sensics/IR_LED_DRV/Schematics/IR_EVB_REV1.xls

Positional tracker Part II Revised: Sunday, March 15, 2015
Rigid_PCBwLEDS.dsn Revision: 2.0
Copyright © 2015 Sensics, Inc.
Bill Of Materials March 15,2015 6:45:58 | Page1
Item | Quantity | Reference | Part | MNF_PN
______________________________________________
1 | 4 | C1,C2,C5,C6 | 22uF | LMK212BJ226MG-T
2 | 9 | C3,C9,C13,C14,C15,C16,C17,C18,C19 | 0.1uF | C0603C105K3PAC
3 | 1 | C4 | NP | C0603C105K3PAC
4 | 1 | C7 | 100uF | C1210C107M9PACTU
5 | 1 | C8 | 10uF | GRM188R60J106ME47D
6 | 2 | C10,C20 | 4.7uF | C0603C475K8PACTU
7 | 2 | C11,C12 | 33pF | ECJ-0EC1H330J
8 | 1 | D1 | BPW 34 S-Z | 720-BPW34S-Z
9 | 1 | D2 | CDBQR0230L | CDBQR0230L
10 | 1 | IR1 | SFH4710 | 720-SFH4710
11 | 1 | JP1 | Jump | RC0402FR-0715KL
12 | 3 | J1,J2,J3 | STX-3120-3B |  | 3 pin 100 mil connector
13 | 40 | LED1,LED2,LED3,LED4,LED5,LED6,LED7,LED8,LED9,LED10,LED11,LED12,LED13,LED14,LED15,LED16,LED17,LED18,LED19,LED20,LED21,LED22,LED23,LED24,LED25,LED26,LED27,LED28,LED29,LED30,LED31,LED32,LED33,LED34,LED35,LED36,LED37,LED38,LED39,LED40 | SFH4253_1 | SFH 4253-Z
14 | 1 | L1 | 2.2 uH | IHLP2525CZER2R2M01
15 | 1 | P1 | 22272041 | 22272041
16 | 1 | P2 | 55460-0472 | 55460-0472
17 | 1 | R1 | 52.3K | ERJ-2RKF5232X
18 | 2 | R2,R3 | 30.1K | ERJ-2RKF3012X
19 | 1 | R4 | 12.1K | RC0402FR-0712KL
20 | 2 | R5,R13 | 10.0K | RC0402FR-0710KL
21 | 6 | R6,R7,R8,R9,R10,R12 | 330 | MCR01MRTF3300
22 | 1 | R11 | 4.99K | RC0603FR-074K99L
23 | 1 | R14 | 75
24 | 1 | R15 | 120 | RC0402FR-07120RL
25 | 1 | SEN1 | WSLP39211L000FEB | WSLP39211L000FEB
26 | 24 | T1,T2,T3,T4,T5,T6,T7,T8,T9,T10,T11,T12,T13,T14,T15,T16,T17,T18,T19,T20,T21,T22,T23,T24 | TP0_8MM |  | NP
27 | 1 | U1 | ST1S31 | ST1S31PUR
28 | 1 | U2 | TPS7A3701DRVT | TPS7A3701DRVT
29 | 6 | U3,U4,U5,U6,U7,U9 | STP16CPC26XTR | STP16CPC26XTR
30 | 1 | U8 | STM8S003K3T6CTR | STM8S003K3T6CTR
31 | 1 | U11 | VSOP5843 | VSOP58438
32 | 1 | WLD1 | LTW-E670DS | LTW-E670DS
33 | 1 | Y1 | 16MHz | ABLS-24.000MHZ-B4-T |  | NOT for assembling
