sensics/IR_LED_DRV/(list of files, cad)

Other CAD files:
stvd_ir_led_drv_project.stp
