sensics/IR_LED_DRV/(threads)

Thread 2 (2016-11-13):

Program-LedHex.ps1 from the repository doesn't match release zip

ChristophHaag, 2016-11-13:
https://github.com/sensics/IR_LED_DRV/blob/master/Program-LedHex.ps1

rpavlik, 2016-12-09:
Oops - that probably shouldn't even be in this repo. Its home is here: https://github.com/sensics/IR-Board-Programmer
