sensics/IR_LED_DRV/Schematics/evk_pcbwleds_u.pdf

1

2

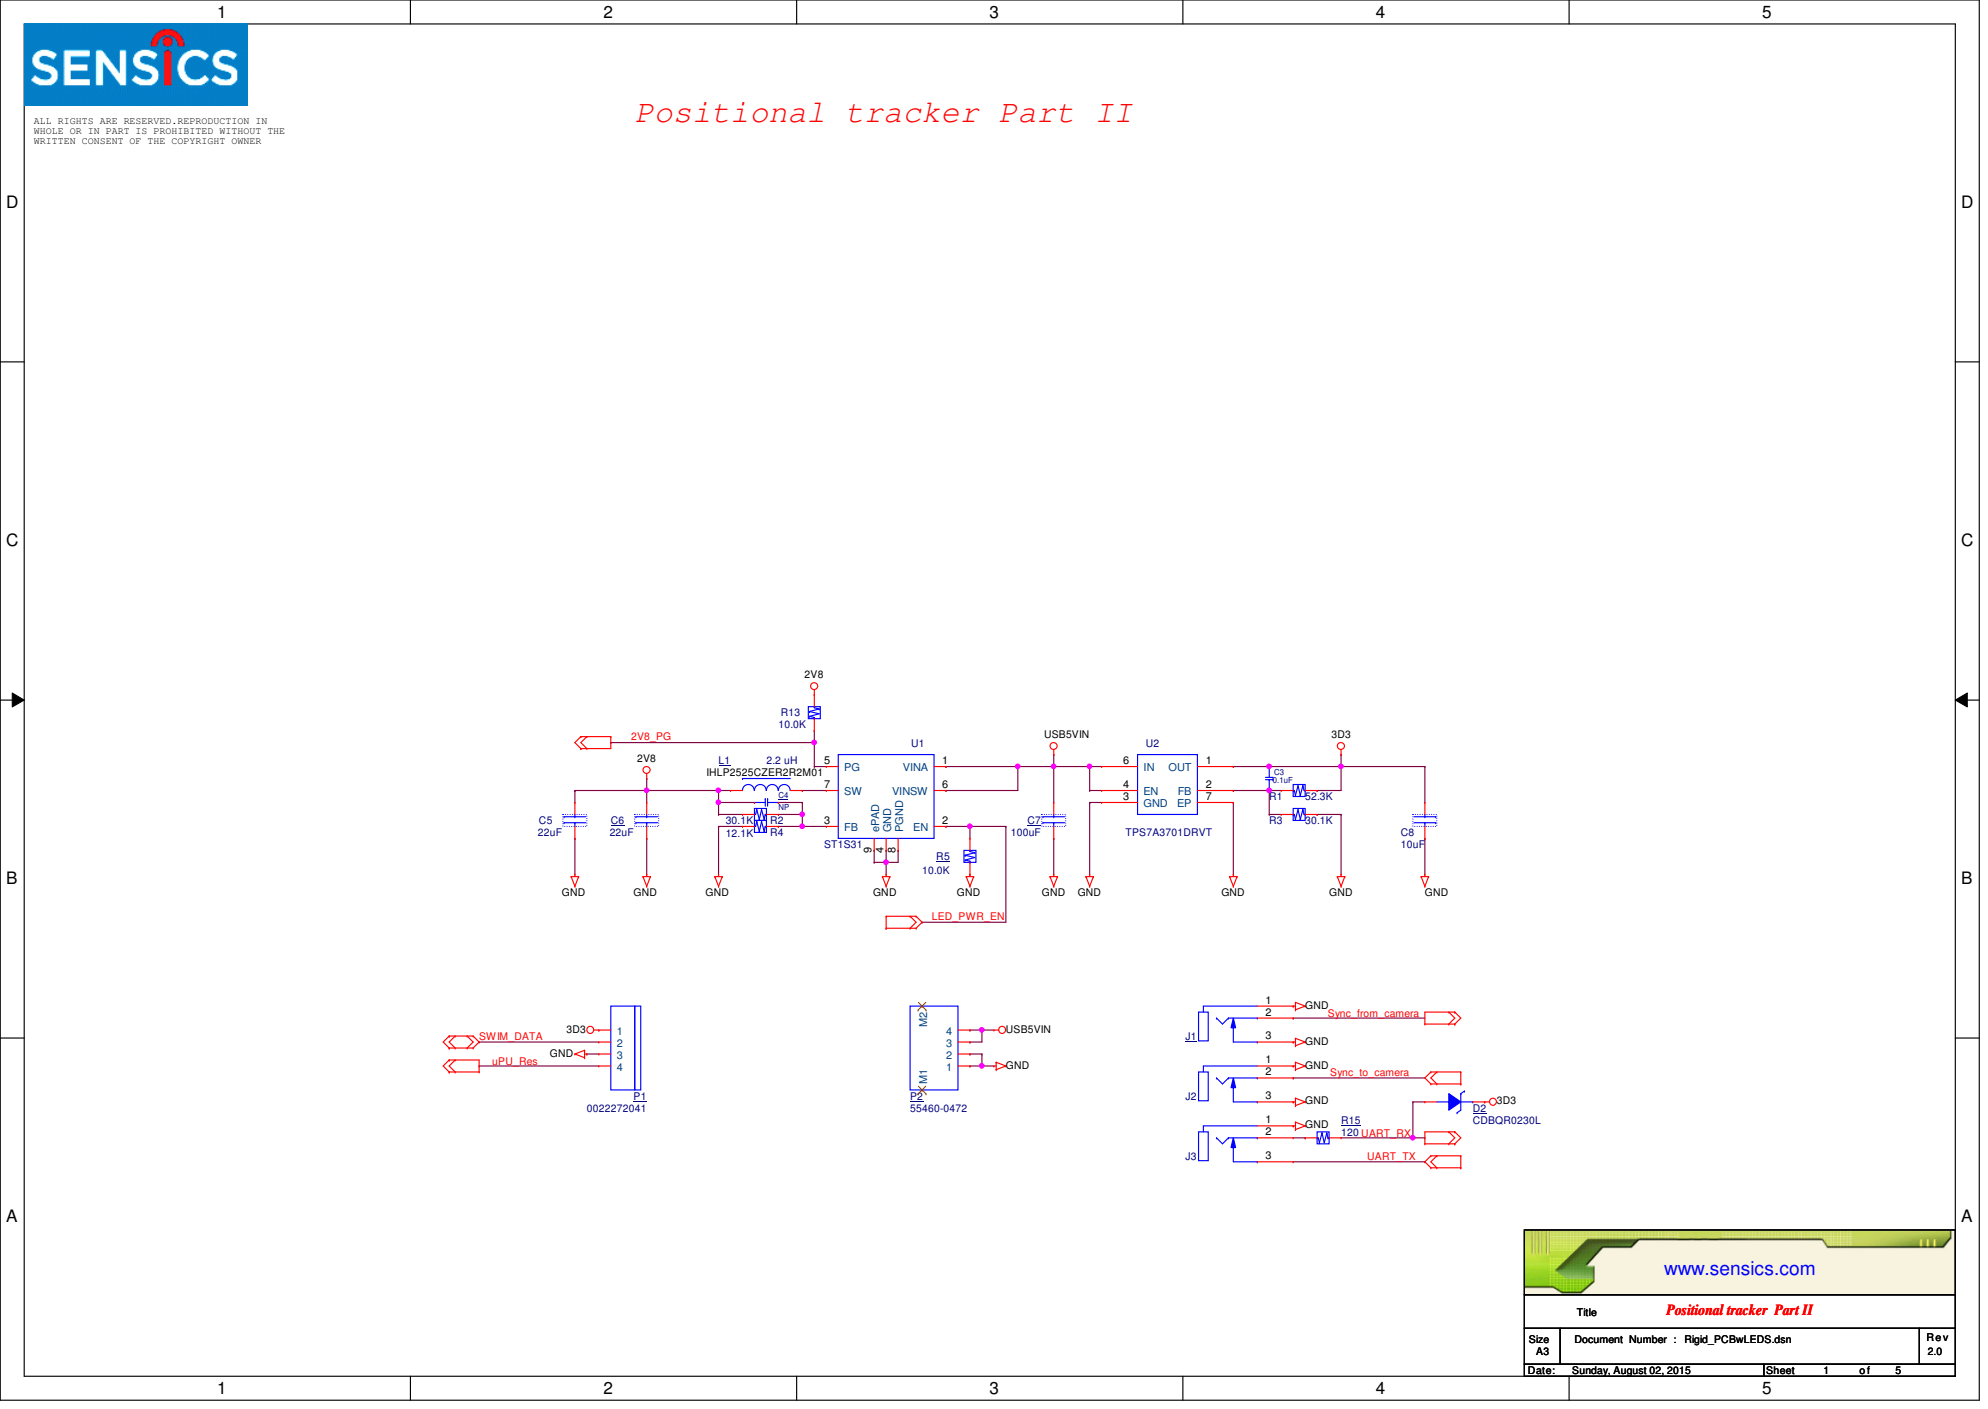
[picture p2: page 1]

Positional tracker Part II

ALL RIGHTS ARE RESERVED.REPRODUCTION IN
WHOLE OR IN PART IS PROHIBITED WITHOUT THE
WRITTEN CONSENT OF THE COPYRIGHT OWNER

D D

# Positional tracker Part II

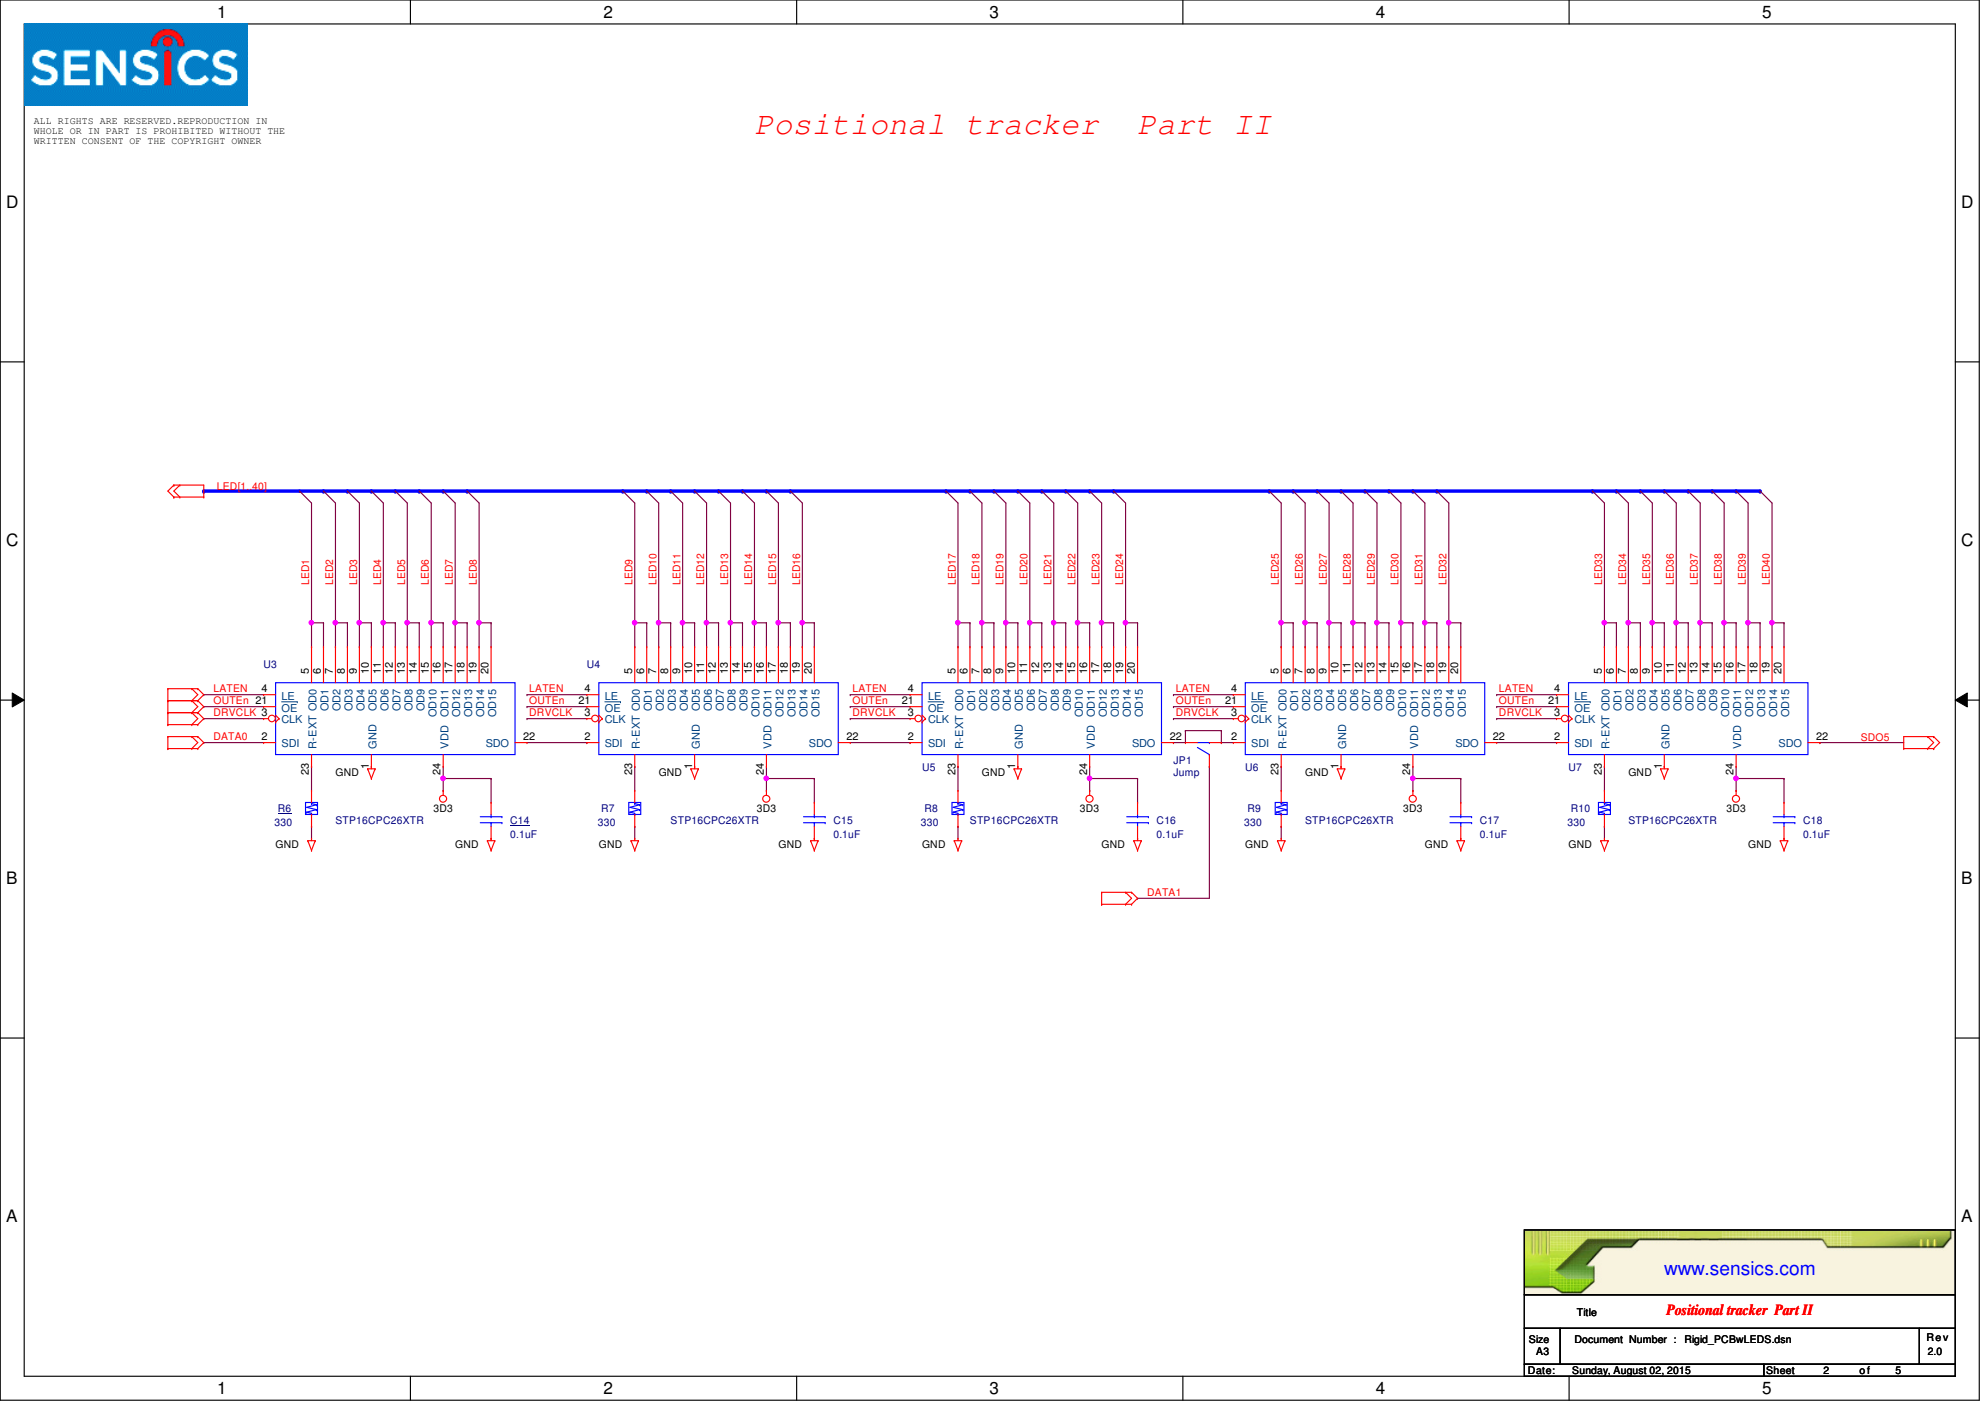
[picture p3: page 2]

WHOLE OR IN PART IS PROHIBITED WITHOUT THE
WRITTEN CONSENT OF THE COPYRIGHT OWNER

D D

# Positional tracker Part II

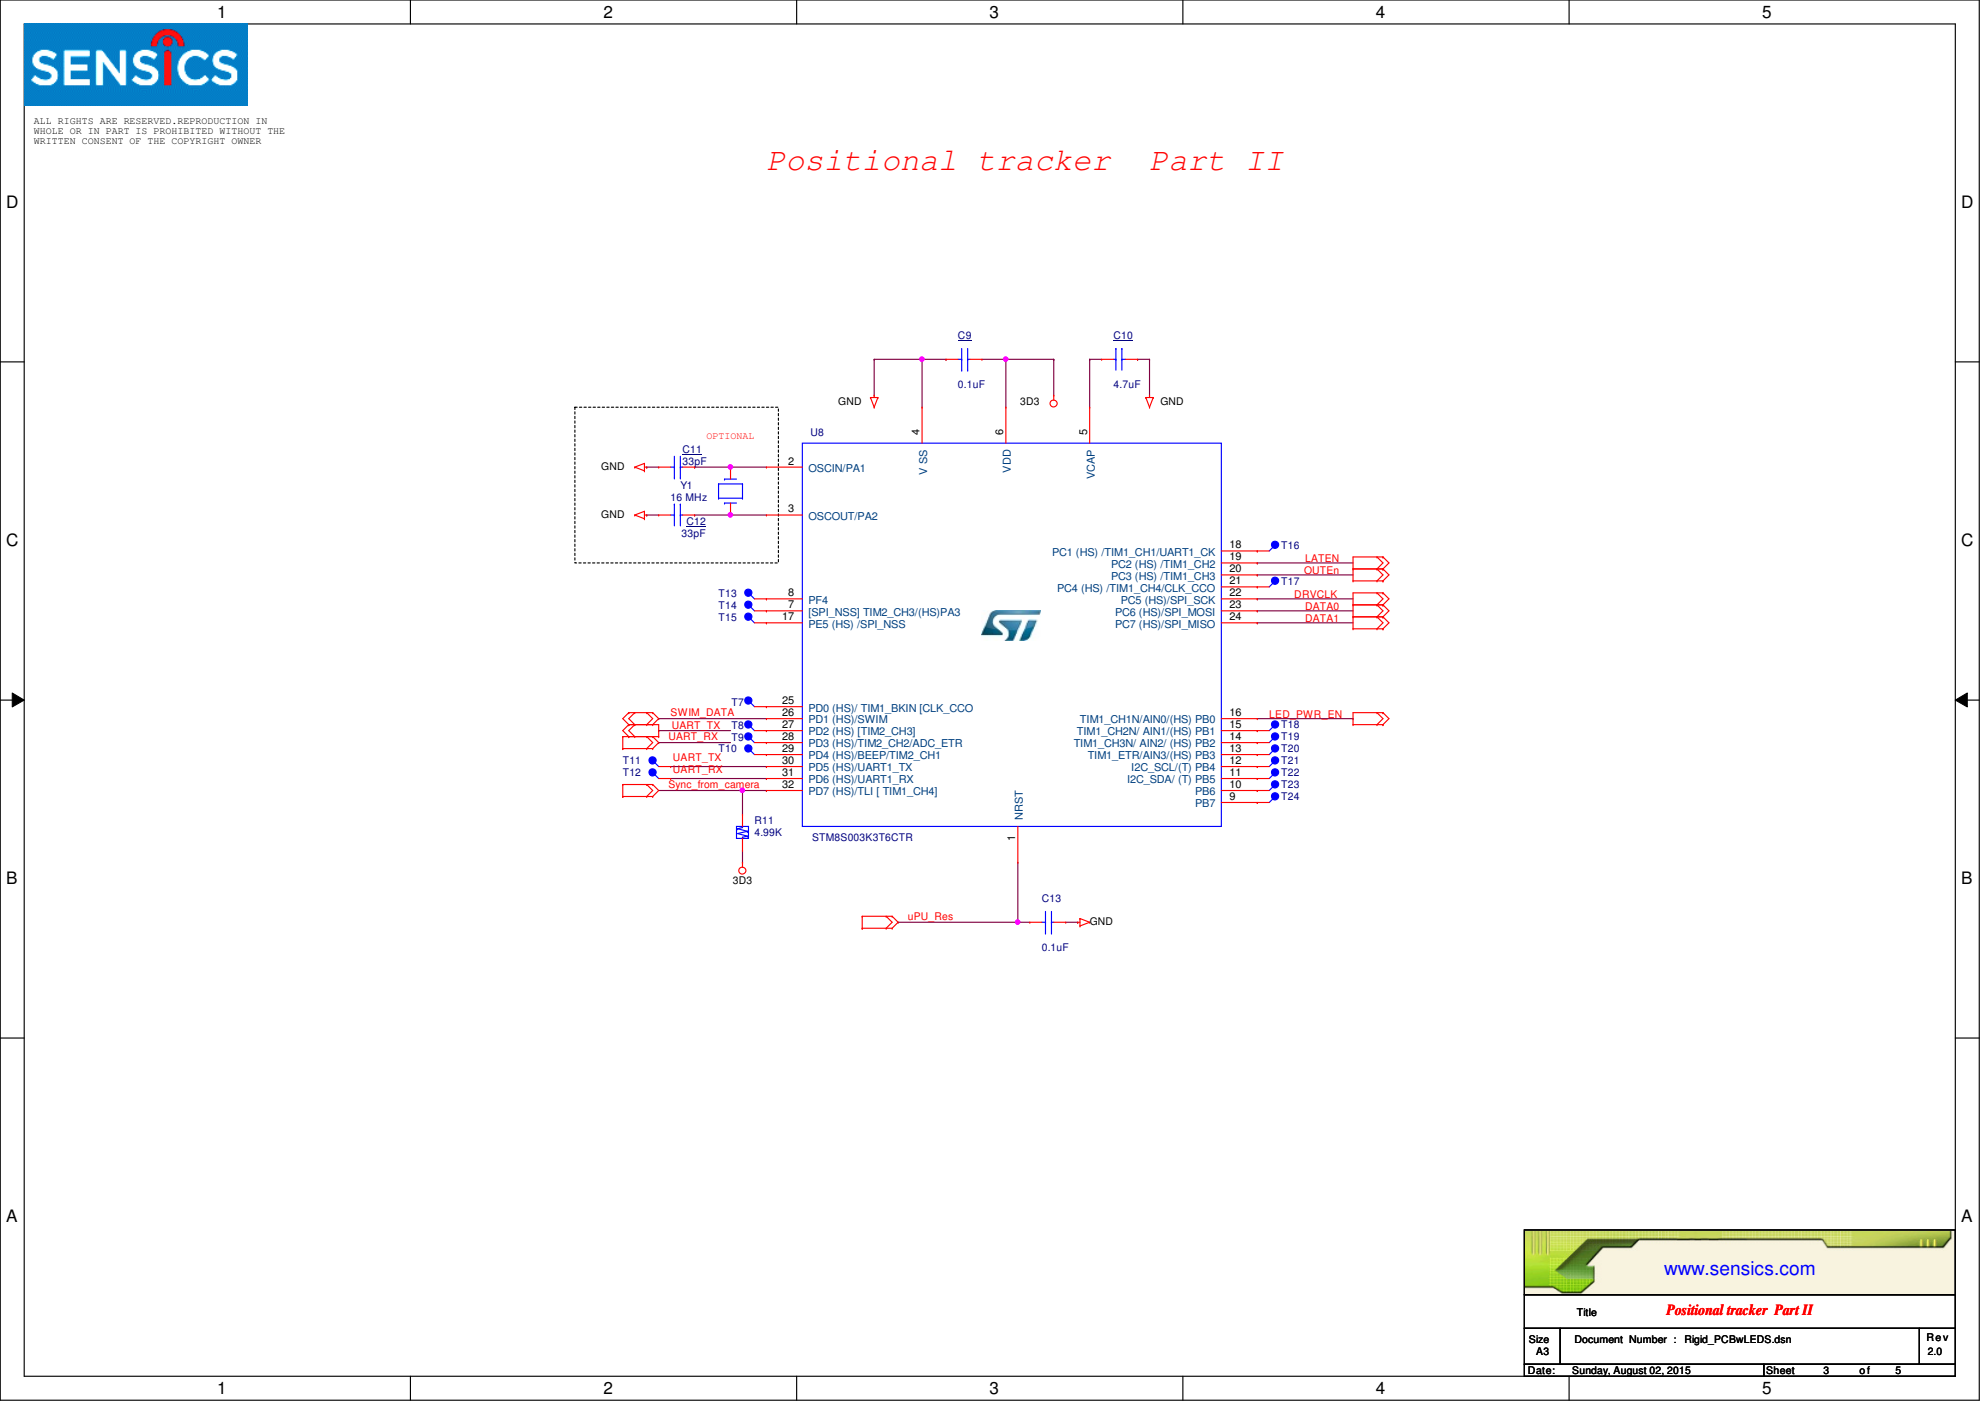
[picture p4: page 3]
OPTIONAL; UART_TX UART_RX; GND; SWIM_DATA; uPU_Res; DRVCLK DATA0; LATEN OUTEn; DATA1; Sync_from_camera; LED_PWR_EN; UART_RX; UART_TX; Sunday, August 02, 2015; Y1 16 MHz; STM8S003K3T6CTR; OSCIN/PA1 2; OSCOUT/PA2 3; VCAP; VDD; [SPI_NSS] TIM2_CH3/(HS)PA3 7; 10 I2C_SDA/ (T) PB5; 11 I2C_SCL/(T) PB4; 12 TIM1_ETR/AIN3/(HS) PB3; 13 TIM1_CH3N/ AIN2/ (HS) PB2; 14 TIM1_CH2N/ AIN1/(HS) PB1; 15 TIM1_CH1N/AIN0/(HS) PB0; PE5 (HS) /SPI_NSS 17; PC1 (HS) /TIM1_CH1/UART1_CK; PC2 (HS) /TIM1_CH2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

WHOLE OR IN PART IS PROHIBITED WITHOUT THE
WRITTEN CONSENT OF THE COPYRIGHT OWNER

www.sensics.com

D D

# Positional tracker Part II

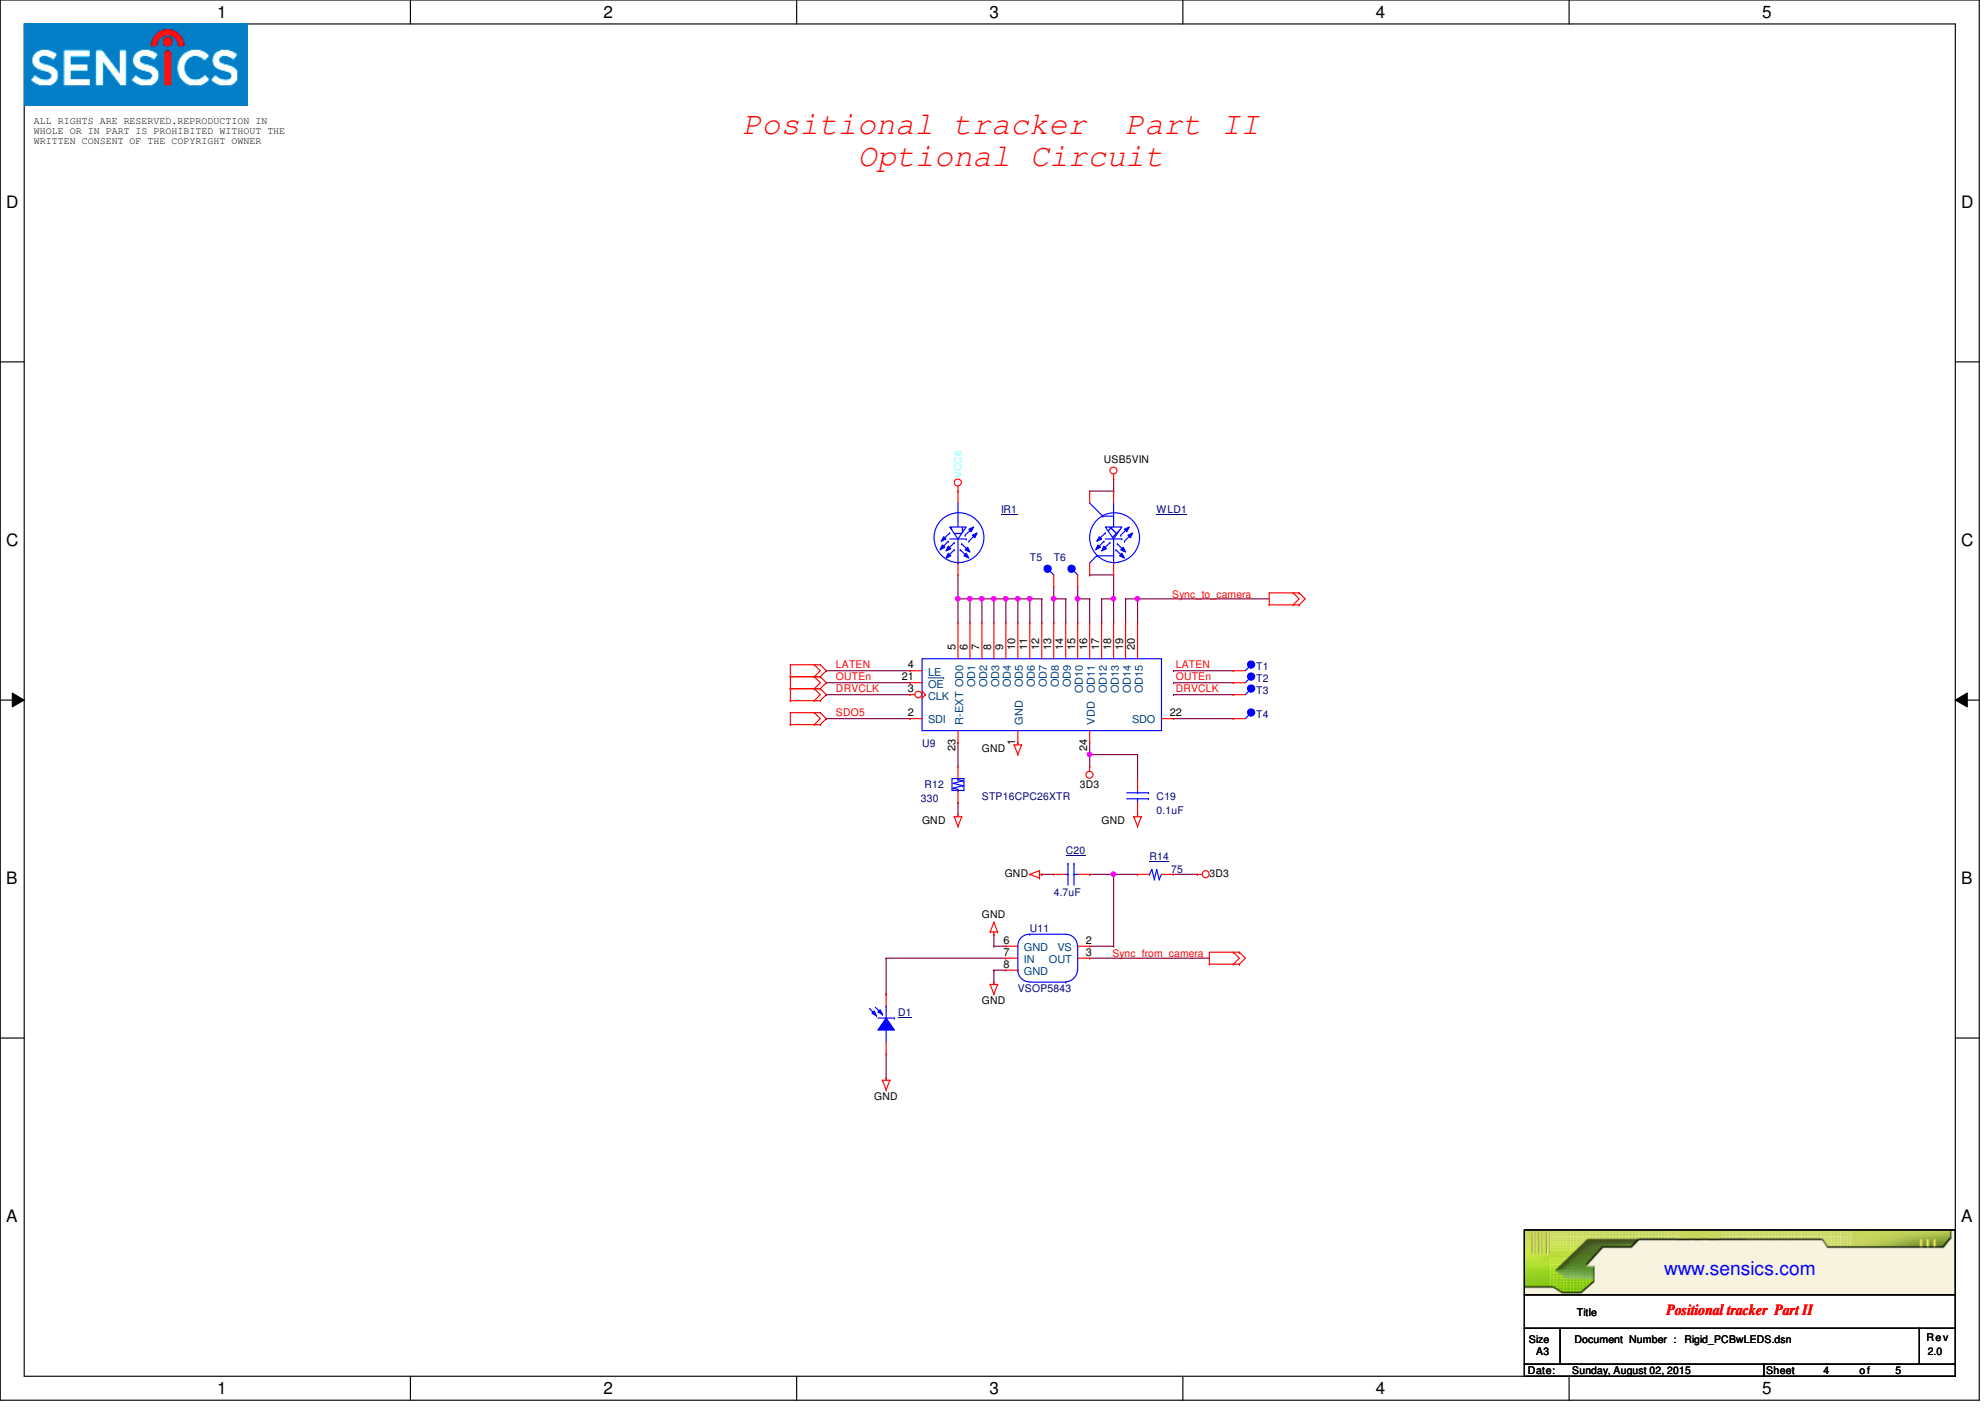
[picture p5: page 4]
Optional Circuit; OUTEn DRVCLK; LATEN; GND; VCC6USB5VIN; SDO5; LATEN OUTEn DRVCLK; Sync_from_camera; Sync_to_camera; Sunday, August 02, 2015; WLD1; STP16CPC26XTR; VDD; SDI 2; SDO; CLK 3; R-EXT; VSOP5843; 2 OUT; 3 GND 6; GND 8

WHOLE OR IN PART IS PROHIBITED WITHOUT THE
WRITTEN CONSENT OF THE COPYRIGHT OWNER

www.sensics.com

D D

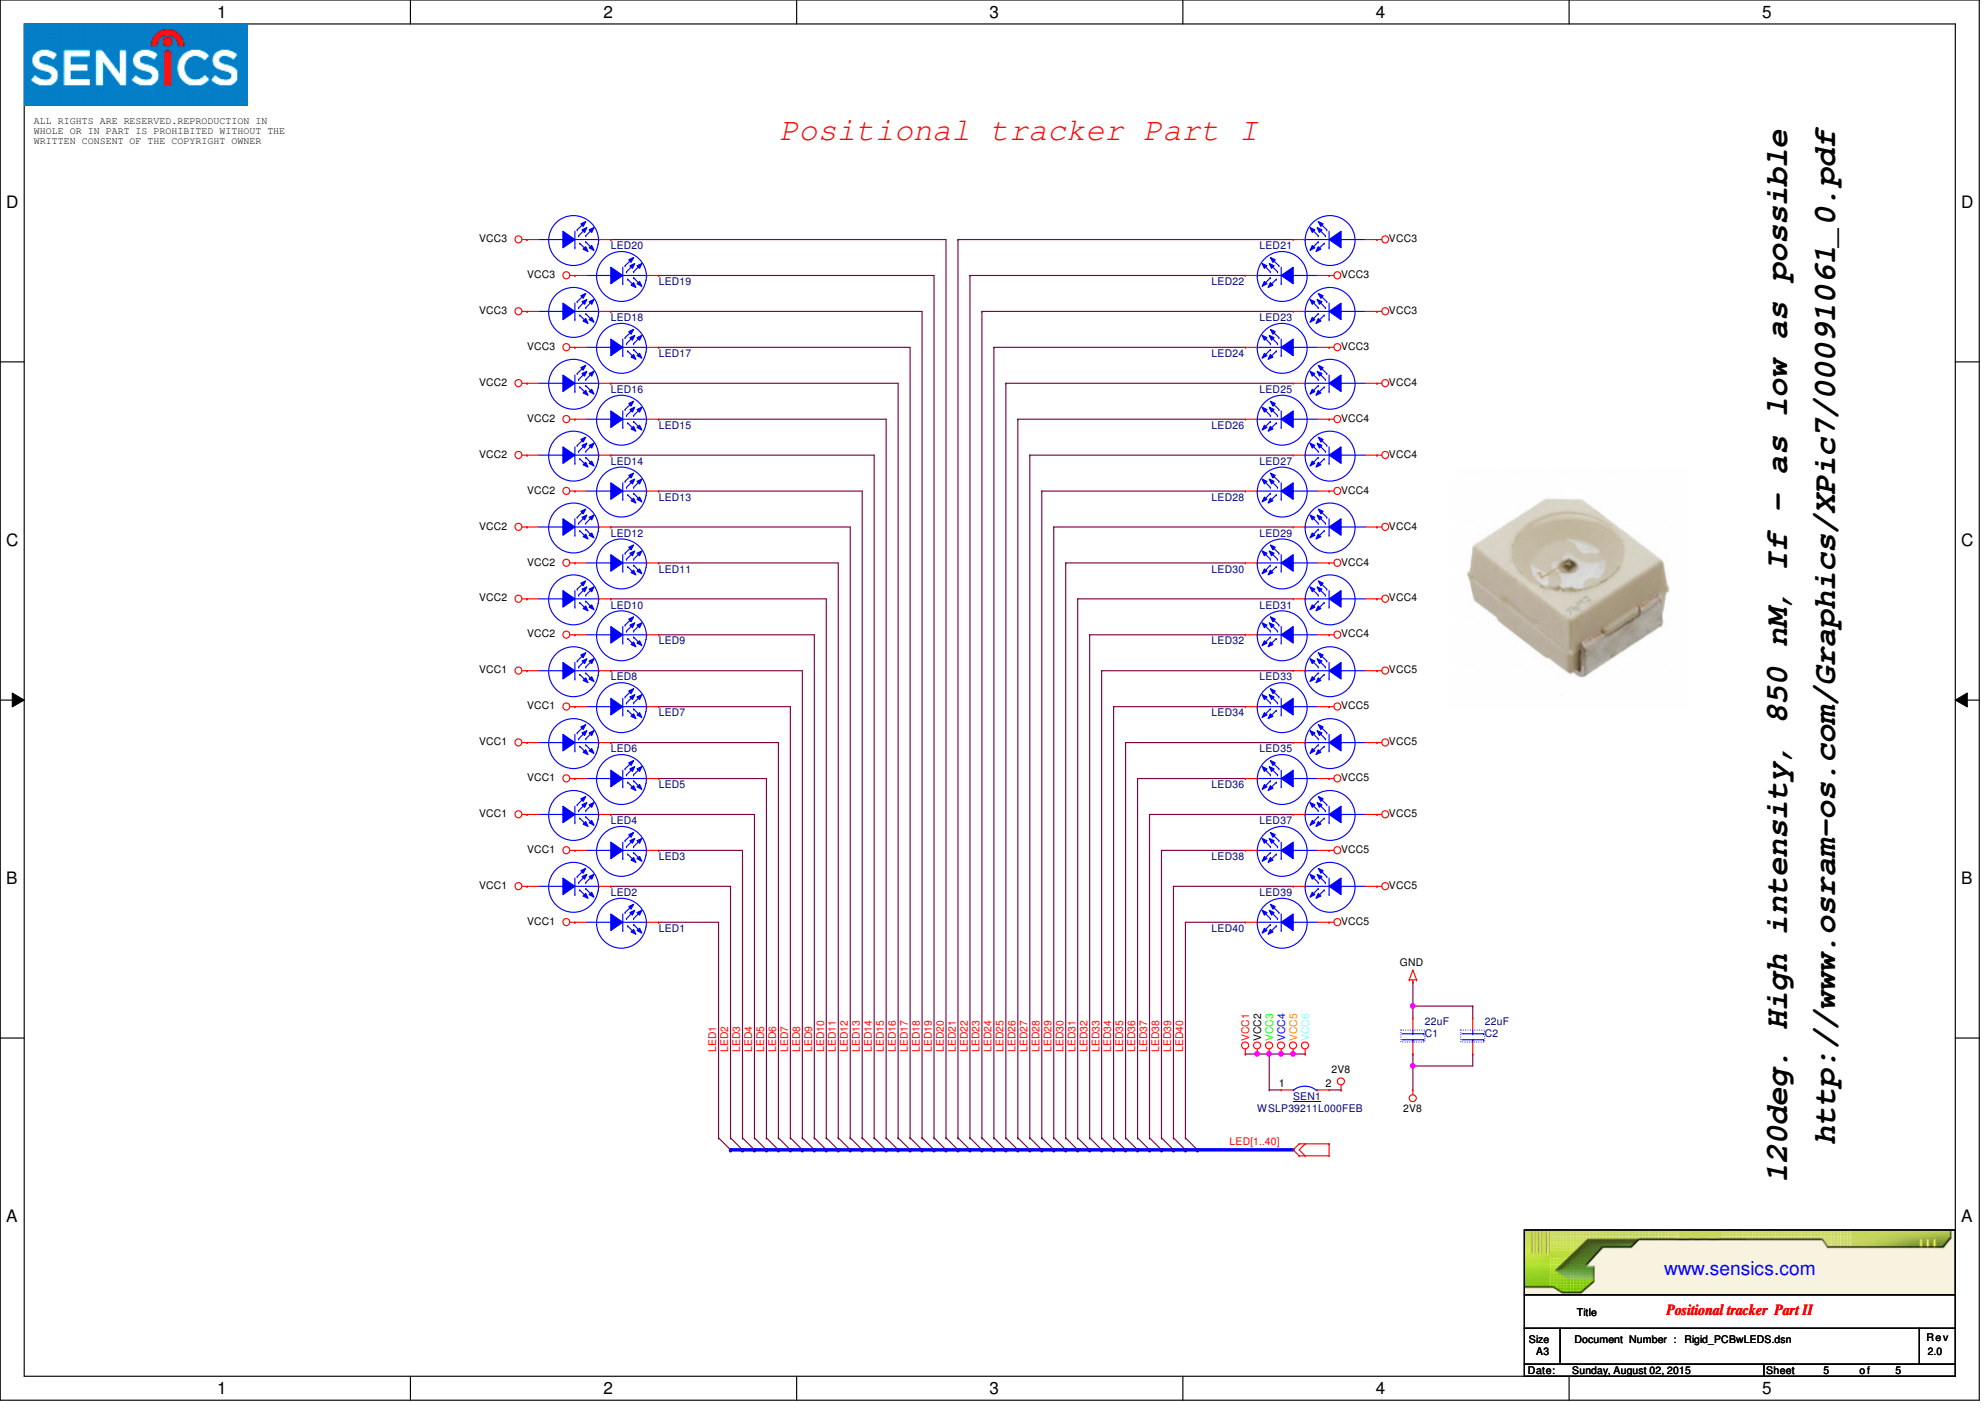
[picture p6: page 5]

WHOLE OR IN PART IS PROHIBITED WITHOUT THE

120deg. High intensity, 850 nM, If - as low as possible

http://www.osram-os.com/Graphics/XPic7/00091061_0.pdf
