sensics/IR_LED_DRV/(list of files, drawings)

Other design files:
Schematics/EVK_PCBWLEDS_U.DSN
