sensics/IR_LED_DRV/User/array_init.c

/** @file
    @brief Implementation

    @date 2015

    @author
    Sensics, Inc.
    <http://sensics.com/osvr>
*/

/*
// Copyright 2015-2016 Sensics, Inc.
//
// Licensed under the Apache License, Version 2.0 (the "License");
// you may not use this file except in compliance with the License.
// You may obtain a copy of the License at
//
//        http://www.apache.org/licenses/LICENSE-2.0
//
// Unless required by applicable law or agreed to in writing, software
// distributed under the License is distributed on an "AS IS" BASIS,
// WITHOUT WARRANTIES OR CONDITIONS OF ANY KIND, either express or implied.
// See the License for the specific language governing permissions and
// limitations under the License.
//
// SPDX-License-Identifier: Apache-2.0
*/

/* Internal Includes */
#include "array_init.h"

/* Library/third-party includes */
#ifdef OSVR_IR_STM8
#include "stm8s.h"
#endif

/* Standard includes */
/* - none - */

// clang-format off

#ifdef HDK2_HARDWARE
/*
Input data producing this mask (HDK2 hardware):
/// Masked LEDs include the six not present in this hardware revision, with additional masked LEDs
/// informed by BrightNeighbors using the distance-cost method with 5 passes (4 LEDs). The last LED
/// suggsted by the algorithm would have been #5, which would have left one side of the HMD quite low
/// in LEDs, so the second-highest cost from that round, #26, was hand chosen instead.
static const auto DISABLED_TARGET0_BEACONS = {
    /// beacons not present in this hardware revision
    12, 13, 14, 25, 27, 28,
    /// beacons disabled due to interference
    33, 18, 32, 26};

/// 1-based indices WRT the tracking software of the beacons on the rear that never light up anyway.
static const auto DISABLED_TARGET1_BEACONS = {1, 4};
*/
EEPROM uint8_t default_mask[LED_LINE_LENGTH] = {0xc9, 0xf3, 0x17, 0xff, 0x6f};

#else
// full beacon set
/*
Input data producing this mask:
/// 1-based indices WRT the tracking software of beacons we'd like to disable.
/// Masked LEDs determined by BrightNeighbors using distance-cost method, 7 passes (6 LEDs).
static const auto DISABLED_TARGET0_BEACONS = {33, 13, 18, 32, 34, 5};

/// 1-based indices WRT the tracking software of the beacons on the rear that never light up anyway.
static const auto DISABLED_TARGET1_BEACONS = {1, 4};
*/
EEPROM uint8_t default_mask[LED_LINE_LENGTH] = {0xf1, 0xff, 0xb7, 0xbf, 0x6f};
#endif


#if 1
EEPROM uint8_t default_pattern_array[PATTERN_COUNT][LED_LINE_LENGTH] =
{
    {29,0,32,136,16},
    {9,0,192,26,4},
    {69,72,1,64,4},
    {162,0,12,2,3},
    {2,48,18,1,10},
    {18,0,5,18,8},
    {3,66,16,17,32},
    {0,37,1,128,36},
    {96,136,34,192,0},
    {2,0,8,101,40},
    {144,2,98,0,130},
    {0,153,136,4,1},
    {96,36,64,4,17},
    {12,2,144,8,80},
    {140,144,4,32,64},
    {13,69,0,32,64}
};
#else
/// Pattern for testing sync.
EEPROM uint8_t default_pattern_array[PATTERN_COUNT][LED_LINE_LENGTH] =
{
    {0x03,0,0x30,0,0},
    {0x03,0,0x30,0,0},
    {0,0x03,0,0,0x30},
    {0,0x03,0,0,0x30},
    {0x30,0,0x03,0,0},
    {0x30,0,0x03,0,0},
    {0,0x30,0,0x03,0},
    {0,0x30,0,0x03,0},
    {0,0,0x30,0,0x03},
    {0,0,0x30,0,0x03},
    {0,0,0,0,0},
    {0,0,0,0,0},
    {0,0,0,0,0},
    {0,0,0,0,0},
    {0,0,0,0,0},
    {0,0,0,0,0}
};
#endif
// clang-format on

NEAR uint8_t pattern_array[PATTERN_COUNT][LED_LINE_LENGTH];

NEAR uint8_t ir_led_driver_buffer[PATTERN_COUNT][DRIVER_BUFFER_LENGTH];

NEAR uint8_t driver_mask[DRIVER_BUFFER_LENGTH];

void expand_array(uint8_t *buffer, uint8_t *value)
{

  uint8_t j, k;
  for (j = 0, k = 0; j < LED_LINE_LENGTH; j++)
  {
    // Process an entire byte of value, bit by bit, within this single loop body.
    // This means we will touch two bytes of buffer.

    // 0x03 is adjacent bits on: 0b00000011

    buffer[k] = 0;
    if (value[j] & 0x01)
      buffer[k] |= (0x03 << 0);
    if (value[j] & 0x02)
      buffer[k] |= (0x03 << 2);
    if (value[j] & 0x04)
      buffer[k] |= (0x03 << 4);
    if (value[j] & 0x08)
      buffer[k] |= (0x03 << 6);
    k++;
    buffer[k] = 0;
    if (value[j] & 0x10)
      buffer[k] |= (0x03 << 0);
    if (value[j] & 0x20)
      buffer[k] |= (0x03 << 2);
    if (value[j] & 0x40)
      buffer[k] |= (0x03 << 4);
    if (value[j] & 0x80)
      buffer[k] |= (0x03 << 6);
    k++;
  }
}

void line_array_init(uint8_t index, uint8_t *value) { expand_array(ir_led_driver_buffer[index], value); }

void default_array_init(void)
{
  uint8_t i;
  for (i = 0; i < PATTERN_COUNT; i++)
  {
    uint8_t j;
    for (j = 0; j < LED_LINE_LENGTH; j++)
    {
      pattern_array[i][j] = default_pattern_array[i][j];
    }
    line_array_init(i, (uint8_t *)pattern_array[i]);
  }
  {
    uint8_t mask[LED_LINE_LENGTH];
    uint8_t j;
    for (j = 0; j < LED_LINE_LENGTH; j++)
    {
      mask[j] = default_mask[j];
    }
    expand_array(driver_mask, mask);
  }
}
