sensics/IR_LED_DRV/(commit log)

2016-08-05 Fix file headers/copyright on non-ST-sourced files.
    [array_init.c, array_init.h, main.c, uart_protocol.c, uart_protocol.h]
2016-08-05 Added hardware schematics
    [FLEX_PCBWLEDS.DSN, RIGID_PCBWLEDS.DSN]
2016-08-05 Added BOM and PDF files, updated schematics
    [EVK_PCBWLEDS_U.DSN, FLEX_PCBWLEDS.DSN, IR_EVB_REV1.xls, RIGID_PCBWLEDS.DSN]
2016-08-05 Added PCB production files
2016-08-05 A basic desktop app to unswizzle/extract the patterns for LEDs from firmware source.
2016-08-05 Add missing prototype in uart_protocol
    [uart_protocol.h]
2016-08-05 Fix array init formatting.
    [array_init.c]
2016-08-05 Exclude unneeded drivers from build
2016-08-05 Adjust comments to be more correct.
    [main.c]
2016-08-05 Reduce LED pulse lengths
2016-08-05 fix comment regarding units - they should actually be microseconds
    [main.c]
2016-08-05 Set pin mode for SPI
2016-08-05 Move port/pin definitions to MCUConfig.h
2016-08-05 Clean up dead code and allow disabling uart code.
2016-08-05 Symbolic interrupt vector IDs.
2016-08-05 Add an SPI helper function and use it.
2016-08-05 Fix build - for some reason making this array static causes linker allocation errors.
    [uart_protocol.c]
2016-08-05 Ensure SPI is sending the bytes we exactly want.
2016-08-05 Correct output of dumpSPI
    [DumpSPI.cpp]
2016-08-05 Correct pin settings for SPI
    [main.c]
2016-08-05 Fix simulation disabled build.
    [main.c]
2016-08-05 Deal with a "shouldn't get here" case.
2016-08-05 uart: be explicit about the memory section to use.
2016-08-05 uart: Better factor out the hex output.
2016-08-05 uart: Cleanup and remove unused code
2016-08-05 Project: switch to small code model
2016-08-05 Cleanups and performance improvements to process timer handler
2016-08-05 Additional optimization to cut sync to nOE time down to 10.64usec.
2016-08-05 Fix up interrupt handler names, based on header.
    [main.c]
2016-08-05 More work - builds on Cosmic, with lower interrupt latency.
    [stvd_ir_led_drv_project.stp]
2016-08-05 Improve Cosmic build.
    [stvd_ir_led_drv_project.stp]
2016-08-05 Slightly inelegant, but entirely functional, workaround for failure to trigger on rise: just poll once we get a fall.
    [MCUConfig.h, main.c]
2016-08-05 Adjust the timer loop calculation to fix an "off by ~4x" scale
    [main.c]
2016-08-05 Increase max flash period to increase how long of a delay we can use the timer for.
2016-08-05 Add a "lockout" state to avoid getting tricked by spurious sync signals immediately after completing flash process.
    [MCUConfig.h, main.c]
2016-08-05 Set delay to best known (5.5ms) for v0007 camera firmware.
2016-08-05 Use the main.h header to make the uart_protocol use a clean interface to the process, that should actually work
    (cleaning up the code in the process)
2016-08-05 Add a powershell script to make it a single step to program the combined hex file to the micro
2016-08-05 comment for program-ledhex
2016-08-05 Fix a pattern for an (inactive) beacon so that we get all matches.
    [MatchPatterns.cpp]
2016-08-05 A little refactoring and addition of LED mask for both bright and dim.
    This allows us to entirely disable LEDs in firmware.
2016-08-05 Add a greedy algorithm to select which LEDs to mask
2016-08-05 Fix GenerateMask to use a custom (and correct) way of turning an array of bools into a bunch of hex bytes.
    [GenerateMask.cpp]
2016-08-05 An LED mask that only disables non-present LEDs, for an initial firmware.
2016-08-05 Revert "An LED mask that only disables non-present LEDs, for an initial firmware."
    This reverts commit 703dec1fdcb7c72c1fad91841b4150482f943271.
    Restores LED masking computed by BrightNeighbors using distance-cost method, 7 passes (6 LEDs).
    [array_init.c]
2016-08-05 Fix production image build script.
    Pretty sure the sysinternals strings command used to take "-q" to turn off
    the startup banner, now it takes "-nobanner". We filter the output anyway,
    so don't pass anything.
